saawsm/SaawLib/3dmodels/oled/096_oled_module_spi.stp

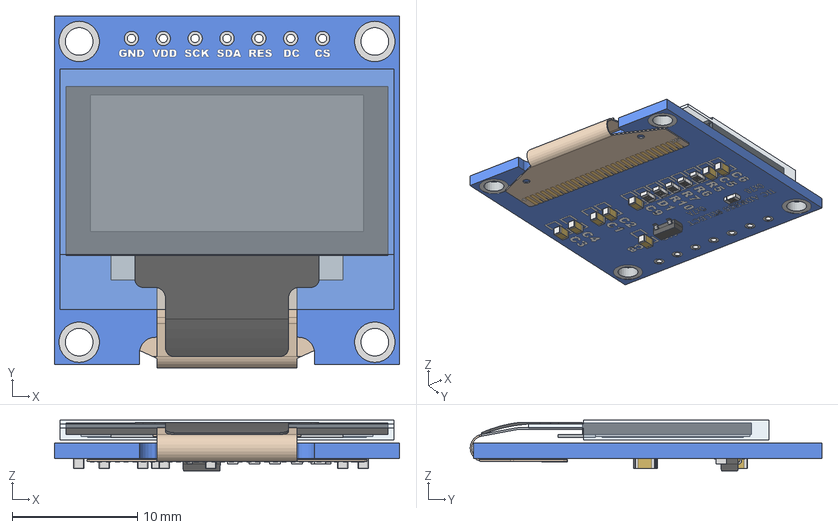
[picture p1: CAD file, 2022-01-30]
3dmodels/oled/096_oled_module_spi.stp
27.5 x 28.0 x 4.03 mm
0.96 OLED - Board - SPI
0.96 OLED - Glass
0.96 OLED - Flat Reverse
0603 Resistor x 6
SOT-23
0603 Capacitor x 8
