saawsm/SaawLib/3dmodels/xt30upb-m.STEP

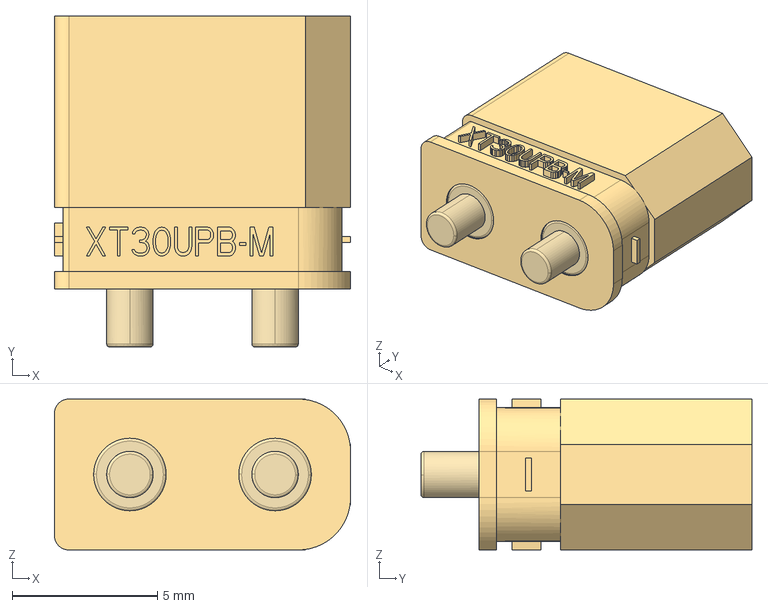
[picture p2: CAD file, 2024-05-21]
3dmodels/xt30upb-m.STEP
10.2 x 11.4 x 5.20 mm
XT30UPB-M
XT30UPB-M-PIN x 2
