saawsm/SaawLib/3dmodels/L_Vishay_IHLP-2525.step

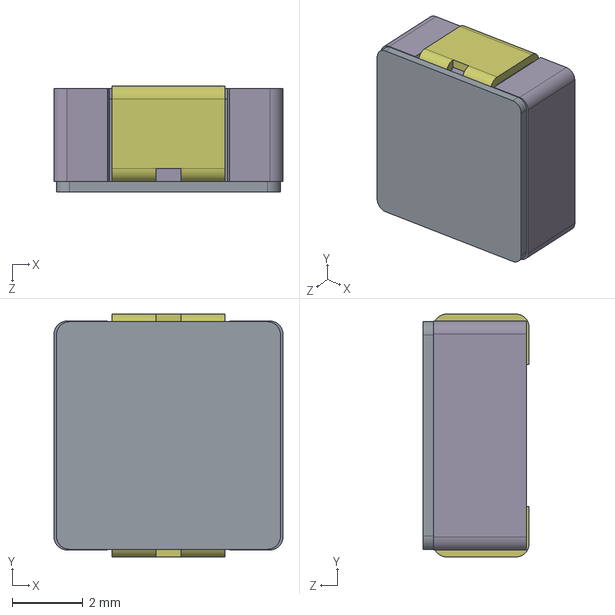
[picture p3: CAD file, 2024-05-21]
3dmodels/L_Vishay_IHLP-2525.step
6.47 x 6.86 x 3.00 mm
