saawsm/SaawLib/3dmodels/STX-2000-3N_rA1.IGS

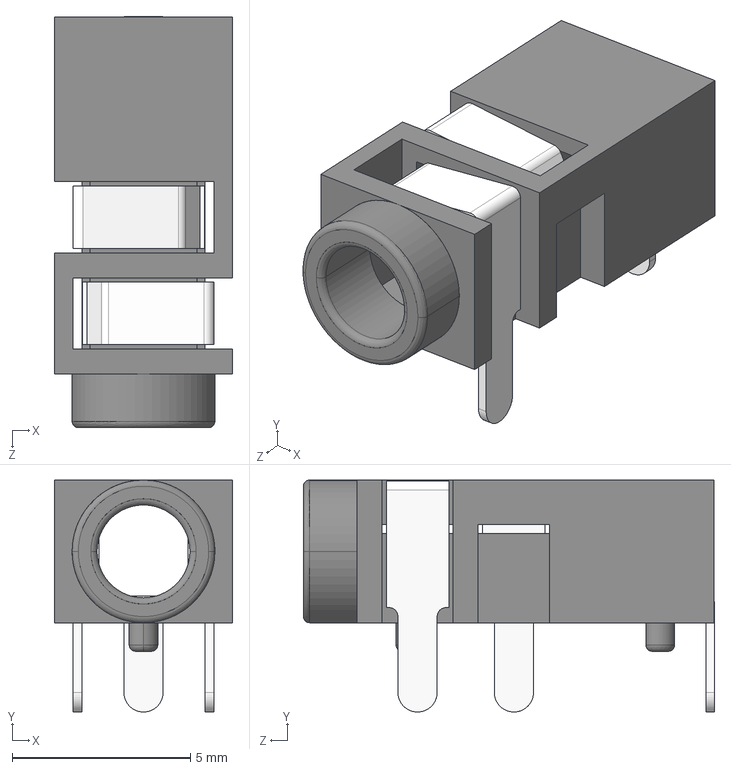
[picture p4: CAD file, 2022-11-05]
3dmodels/STX-2000-3N_rA1.IGS
5.00 x 6.50 x 11.5 mm
