saawsm/SaawLib/3dmodels/500SSPxS2M6xEA.step

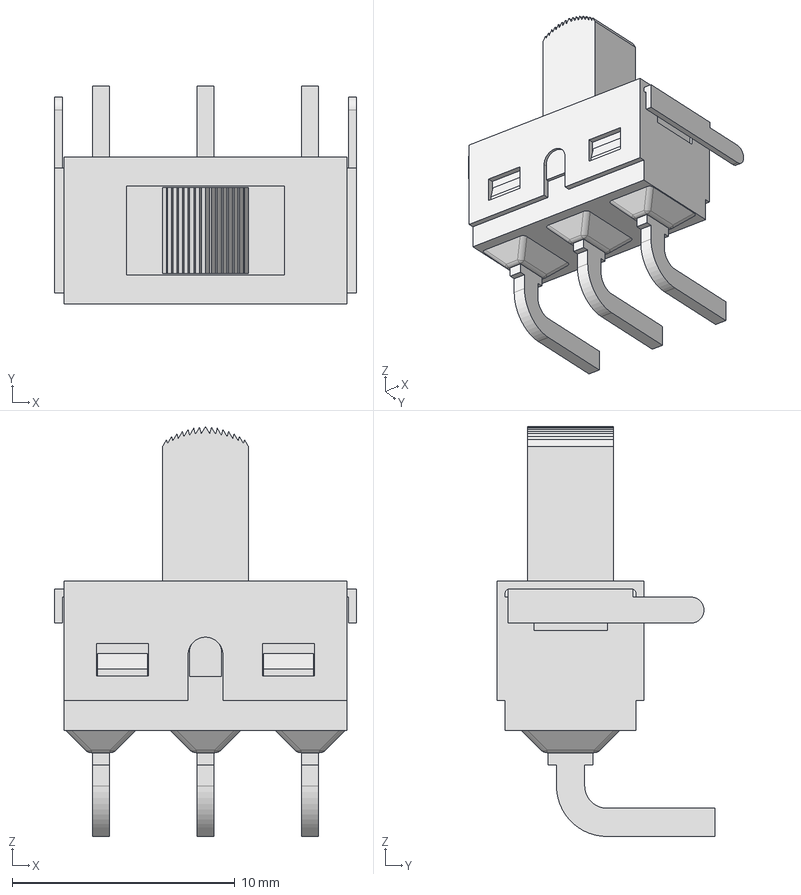
[picture p5: CAD file, 2022-11-05]
3dmodels/500SSPxS2M6xEA.step
13.6 x 9.78 x 18.4 mm
