saawsm/SaawLib/3dmodels/MP3V5050GP.step

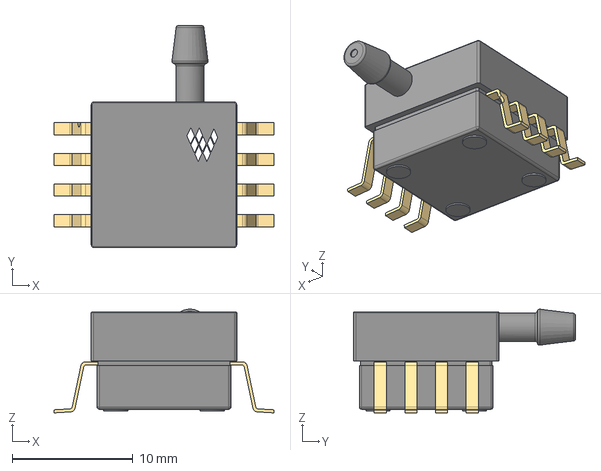
[picture p6: CAD file, 2022-02-22]
3dmodels/MP3V5050GP.step
18.2 x 18.4 x 8.61 mm
