saawsm/SaawLib/3dmodels/Xicon_42TL.STEP

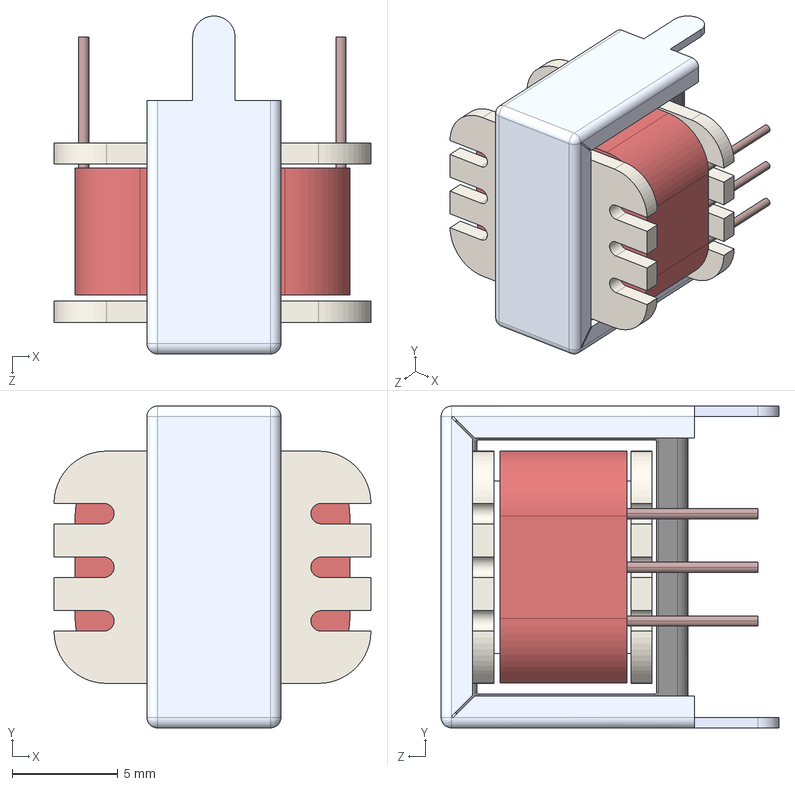
[picture p7: CAD file, 2022-01-30]
3dmodels/Xicon_42TL.STEP
15.0 x 15.2 x 16.0 mm
bobbin001_1
xfm_cover_bracket_1
