saawsm/SaawLib/3dmodels/CUI_DEVICES_PJ-102AH.step

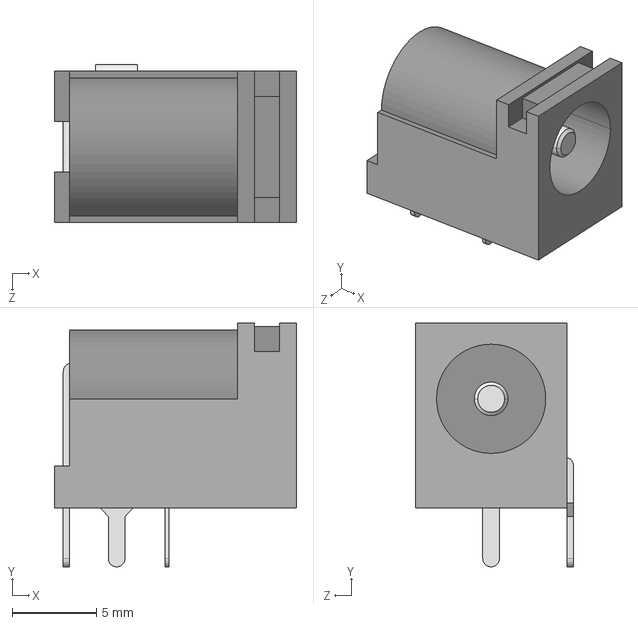
[picture p8: CAD file, 2022-01-30]
3dmodels/CUI_DEVICES_PJ-102AH.step
14.4 x 14.5 x 9.40 mm
