saawsm/SaawLib/3dmodels/pec11r-4x15k-sxxxx.stp

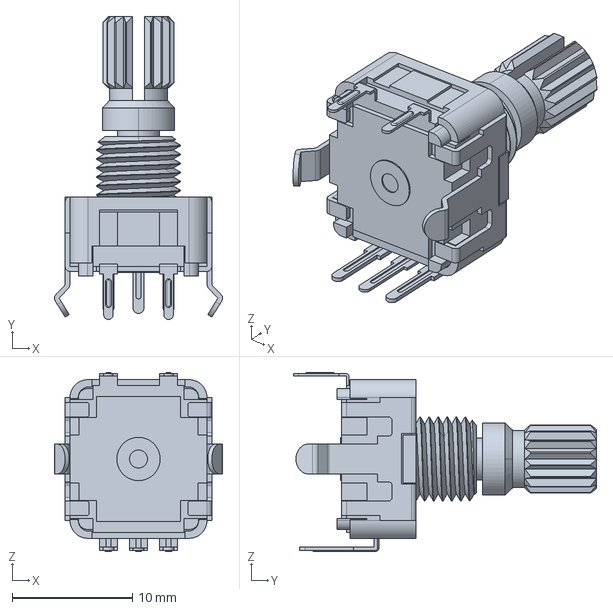
[picture p9: CAD file, 2022-01-30]
3dmodels/pec11r-4x15k-sxxxx.stp
14.0 x 25.2 x 14.9 mm
