saawsm/SaawLib/3dmodels/SKRKAEE020.STEP

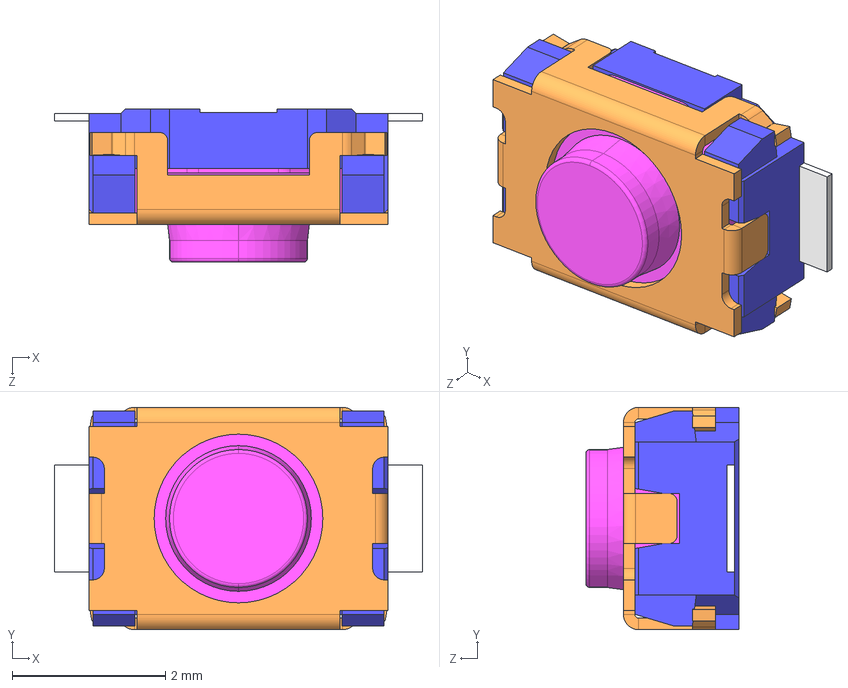
[picture p10: CAD file, 2022-01-30]
3dmodels/SKRKAEE020.STEP
4.80 x 2.90 x 2.00 mm
