saawsm/SaawLib/3dmodels/STX-3100-5N_rA5.STEP

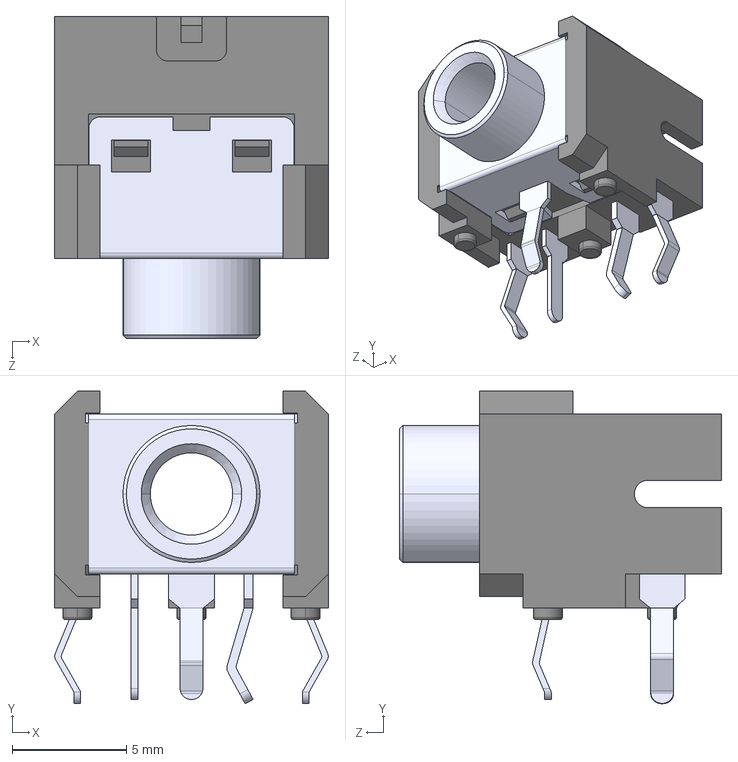
[picture p11: CAD file, 2022-01-30]
3dmodels/STX-3100-5N_rA5.STEP
12.0 x 13.7 x 14.1 mm
