saawsm/SaawLib/(list of files, cad)

Other CAD files:
3dmodels/oled/096_oled_module_i2c.stp
