saawsm/SaawLib/(commit log)

2022-02-02 add SW-3240 module symbols/footprints
2022-02-02 add bridged123 solder jumper
2022-02-06 add silkscreen pin labels
2022-02-22 add mp3v5050gp
    [MP3V5050GP.step]
2022-02-22 add esp32 module footprint
2022-04-07 add footprints
2022-04-07 improve silkscreen names
2022-06-29 fix pin name
2022-06-29 add Pico footprint
2022-11-05 sync & cleanup
    [500SSPxS2M6xEA.step, STX-2000-3N_rA1.IGS]
2022-11-14 add Nidec ST-4EB trimmer footprint
2024-03-06 remove obsolete footprints
2024-05-21 add IHLP-2525 3D model
    [L_Vishay_IHLP-2525.step]
2024-05-21 add XT30UPB-M 3D model
    [xt30upb-m.STEP]
2024-05-24 remove redundant PTV09A footprint
2024-06-10 add thermal via footprint variants
